GabrielBeraldo/pulvertech/pulvertech_V1/IHM/sources/boot-480x272.png

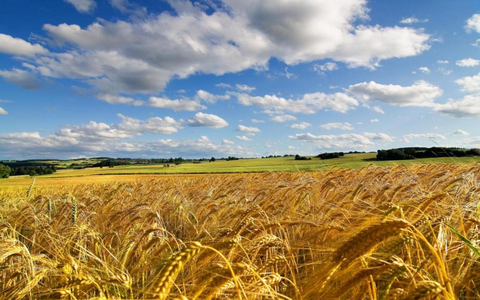
pulvertech_V1/IHM/sources/boot-480x272.png
