GabrielBeraldo/pulvertech/Logs/ControlResponse.jpg

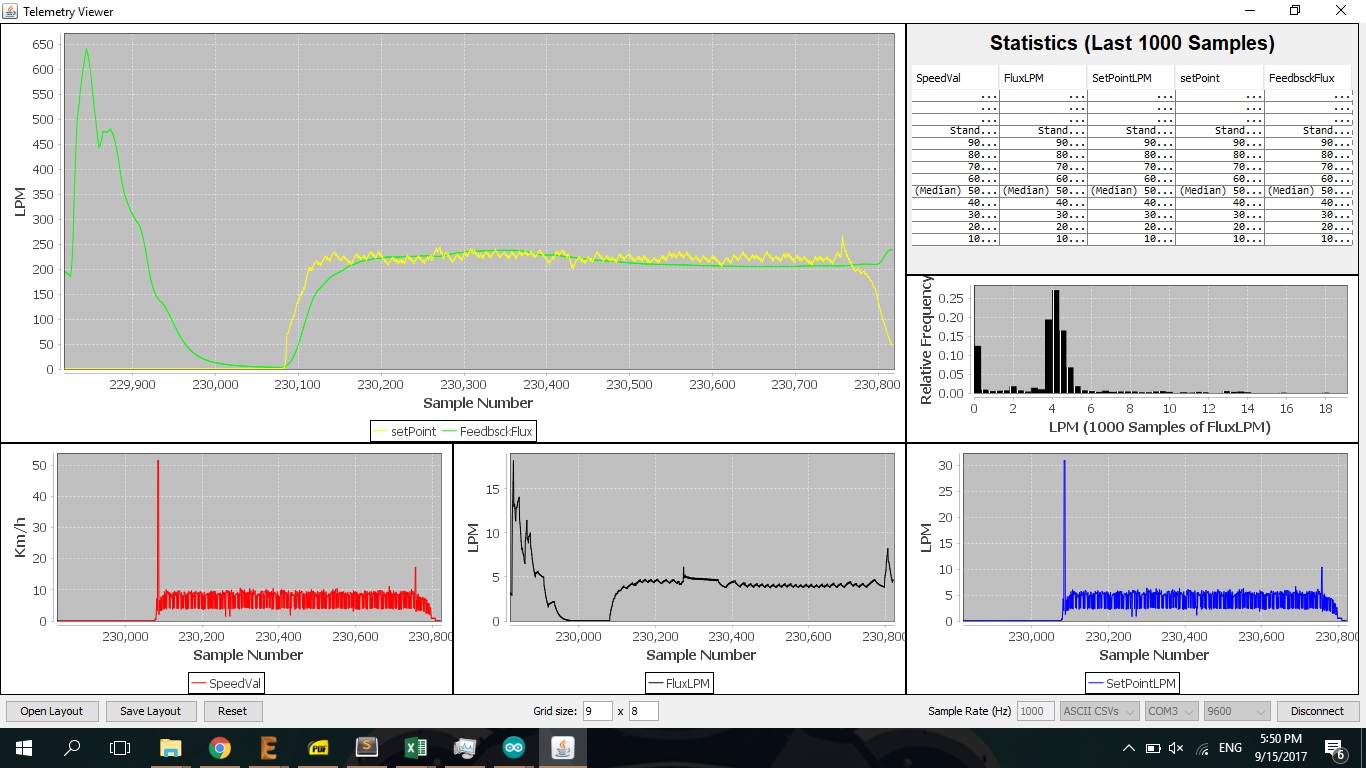
Logs/ControlResponse.jpg
