GabrielBeraldo/pulvertech/pulvertech_V1/IHM/gauges/back.jpg

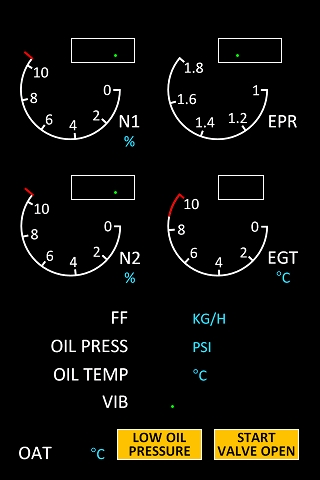
pulvertech_V1/IHM/gauges/back.jpg
