GabrielBeraldo/pulvertech/extras/fometerHoseAdapter.stl

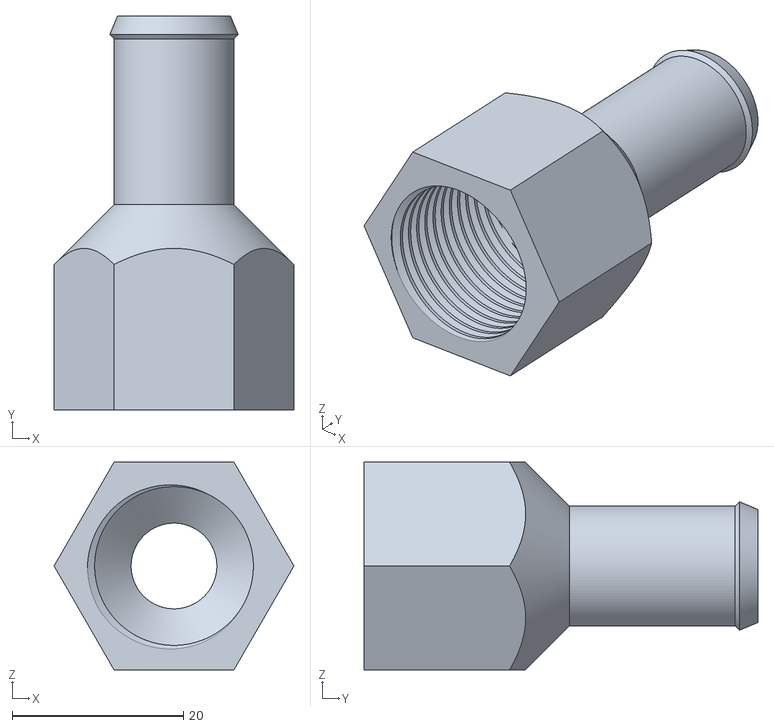
[picture p4: CAD file, 2020-08-11]
extras/fometerHoseAdapter.stl
28.0 x 46.0 x 24.2
