GabrielBeraldo/pulvertech/extras/top_case.stl

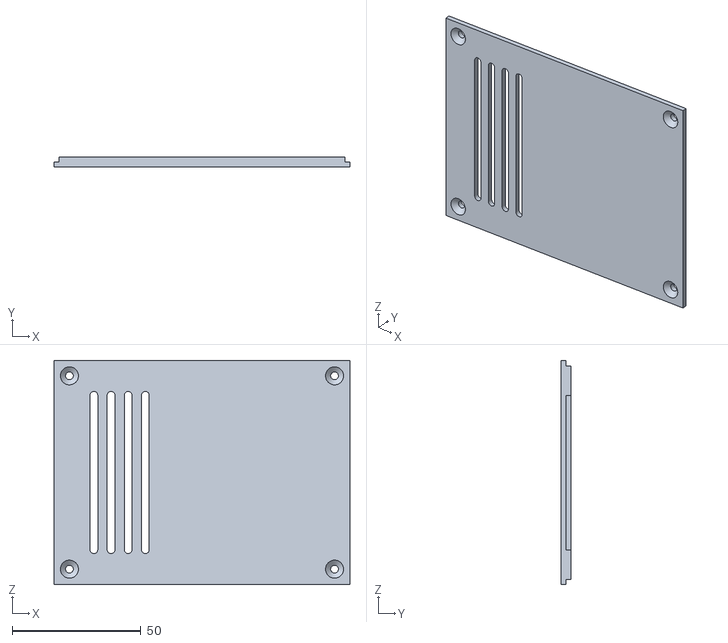
[picture p5: CAD file, 2019-11-14]
extras/top_case.stl
115.0 x 4.00 x 87.1
