GabrielBeraldo/pulvertech/extras/displayCaseBottom.stl

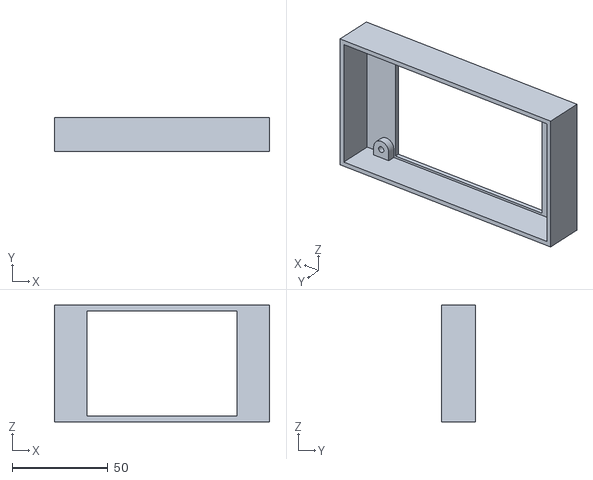
[picture p6: CAD file, 2019-11-14]
extras/displayCaseBottom.stl
112.2 x 18.0 x 61.0
