GabrielBeraldo/pulvertech/extras/displayCaseTop.stl

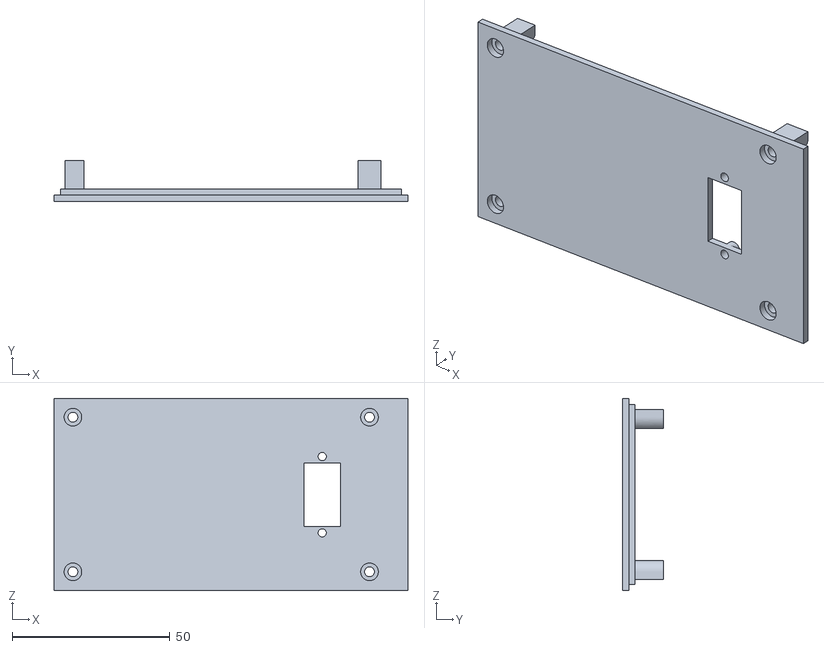
[picture p7: CAD file, 2019-11-14]
extras/displayCaseTop.stl
112.2 x 13.0 x 61.0
