GabrielBeraldo/pulvertech/extras/conector_vazao_flux.stl

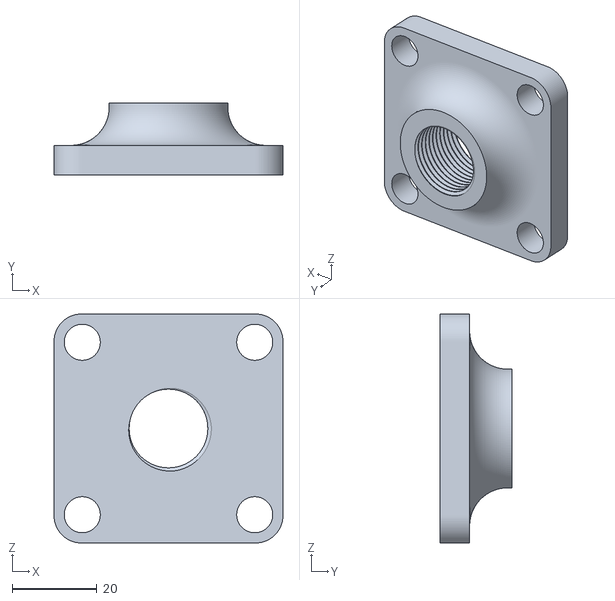
[picture p8: CAD file, 2019-06-24]
extras/conector_vazao_flux.stl
54.0 x 17.0 x 54.0
