GabrielBeraldo/pulvertech/extras/feedbackFlux15lines.stl

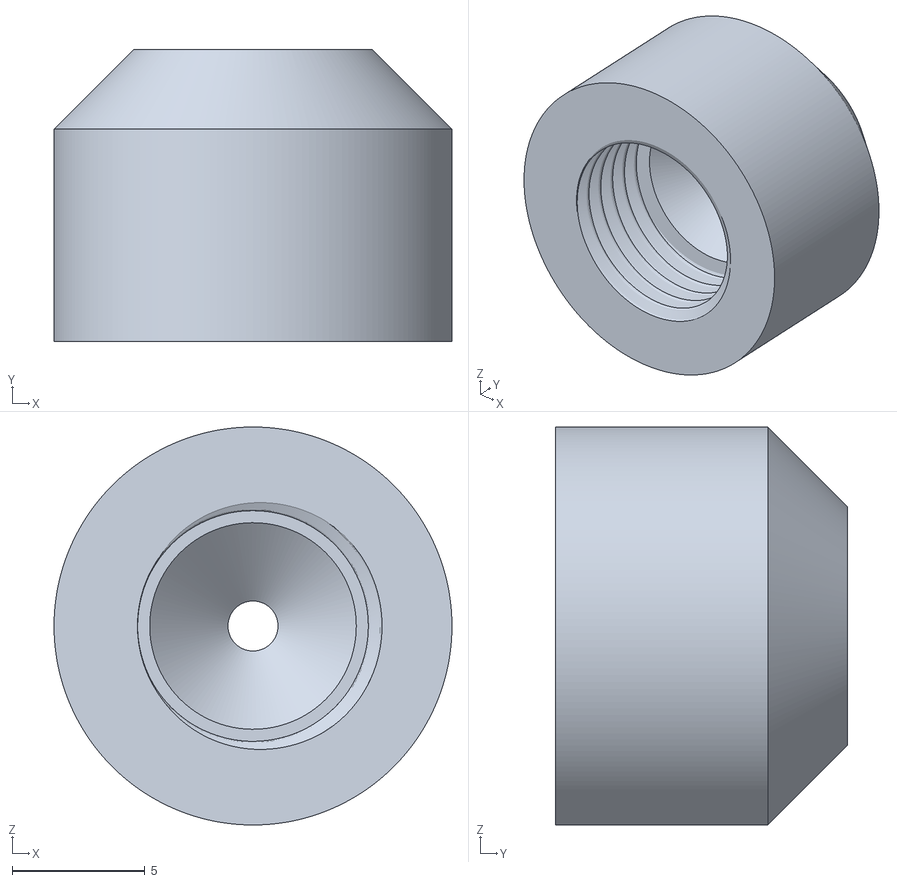
[picture p9: CAD file, 2019-06-24]
extras/feedbackFlux15lines.stl
15.0 x 11.0 x 15.0
