GabrielBeraldo/pulvertech/extras/conector_vazao.SLDPRT

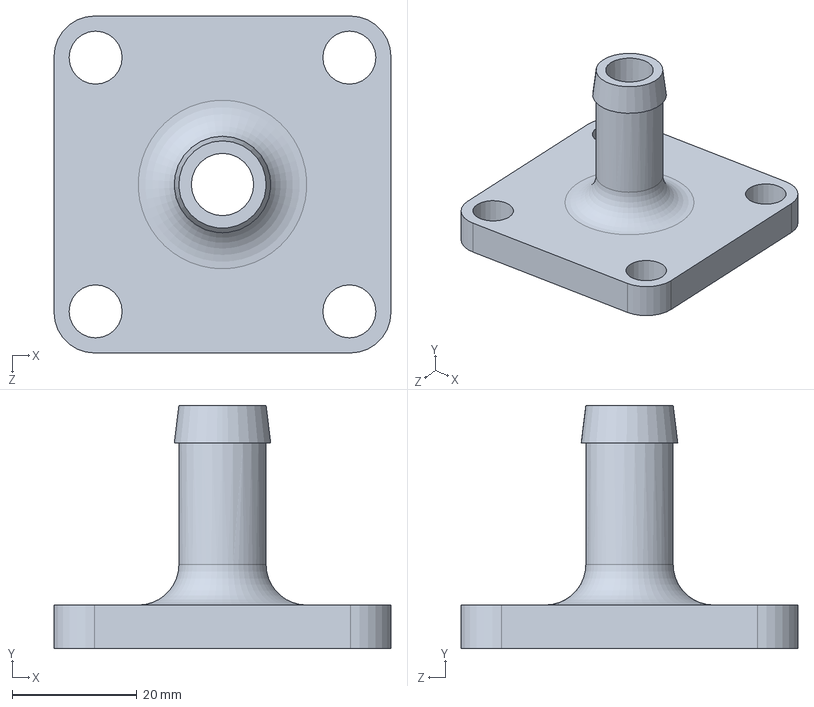
[picture p10: CAD file, 2018-02-22]
extras/conector_vazao.SLDPRT
54.0 x 39.0 x 54.0 mm
