GabrielBeraldo/pulvertech/extras/tampa_vazao.SLDPRT

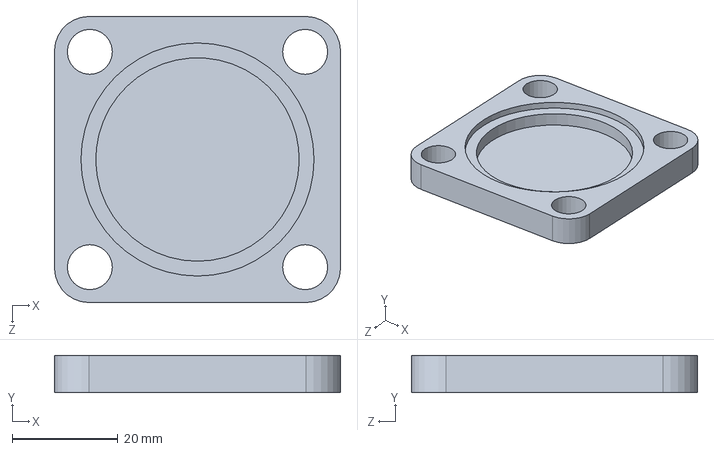
[picture p11: CAD file, 2018-02-22]
extras/tampa_vazao.SLDPRT
54.0 x 7.00 x 54.0 mm
