GabrielBeraldo/pulvertech/(list of files, cad)

Other CAD files:
extras/conector_vazao.STL
extras/tampa_vazao.STL
