GabrielBeraldo/pulvertech/Boards/PulverTech_v1/PulverTech_v1.brd

## EAGLE design Boards/PulverTech_v1/PulverTech_v1.brd (2019-11-14)

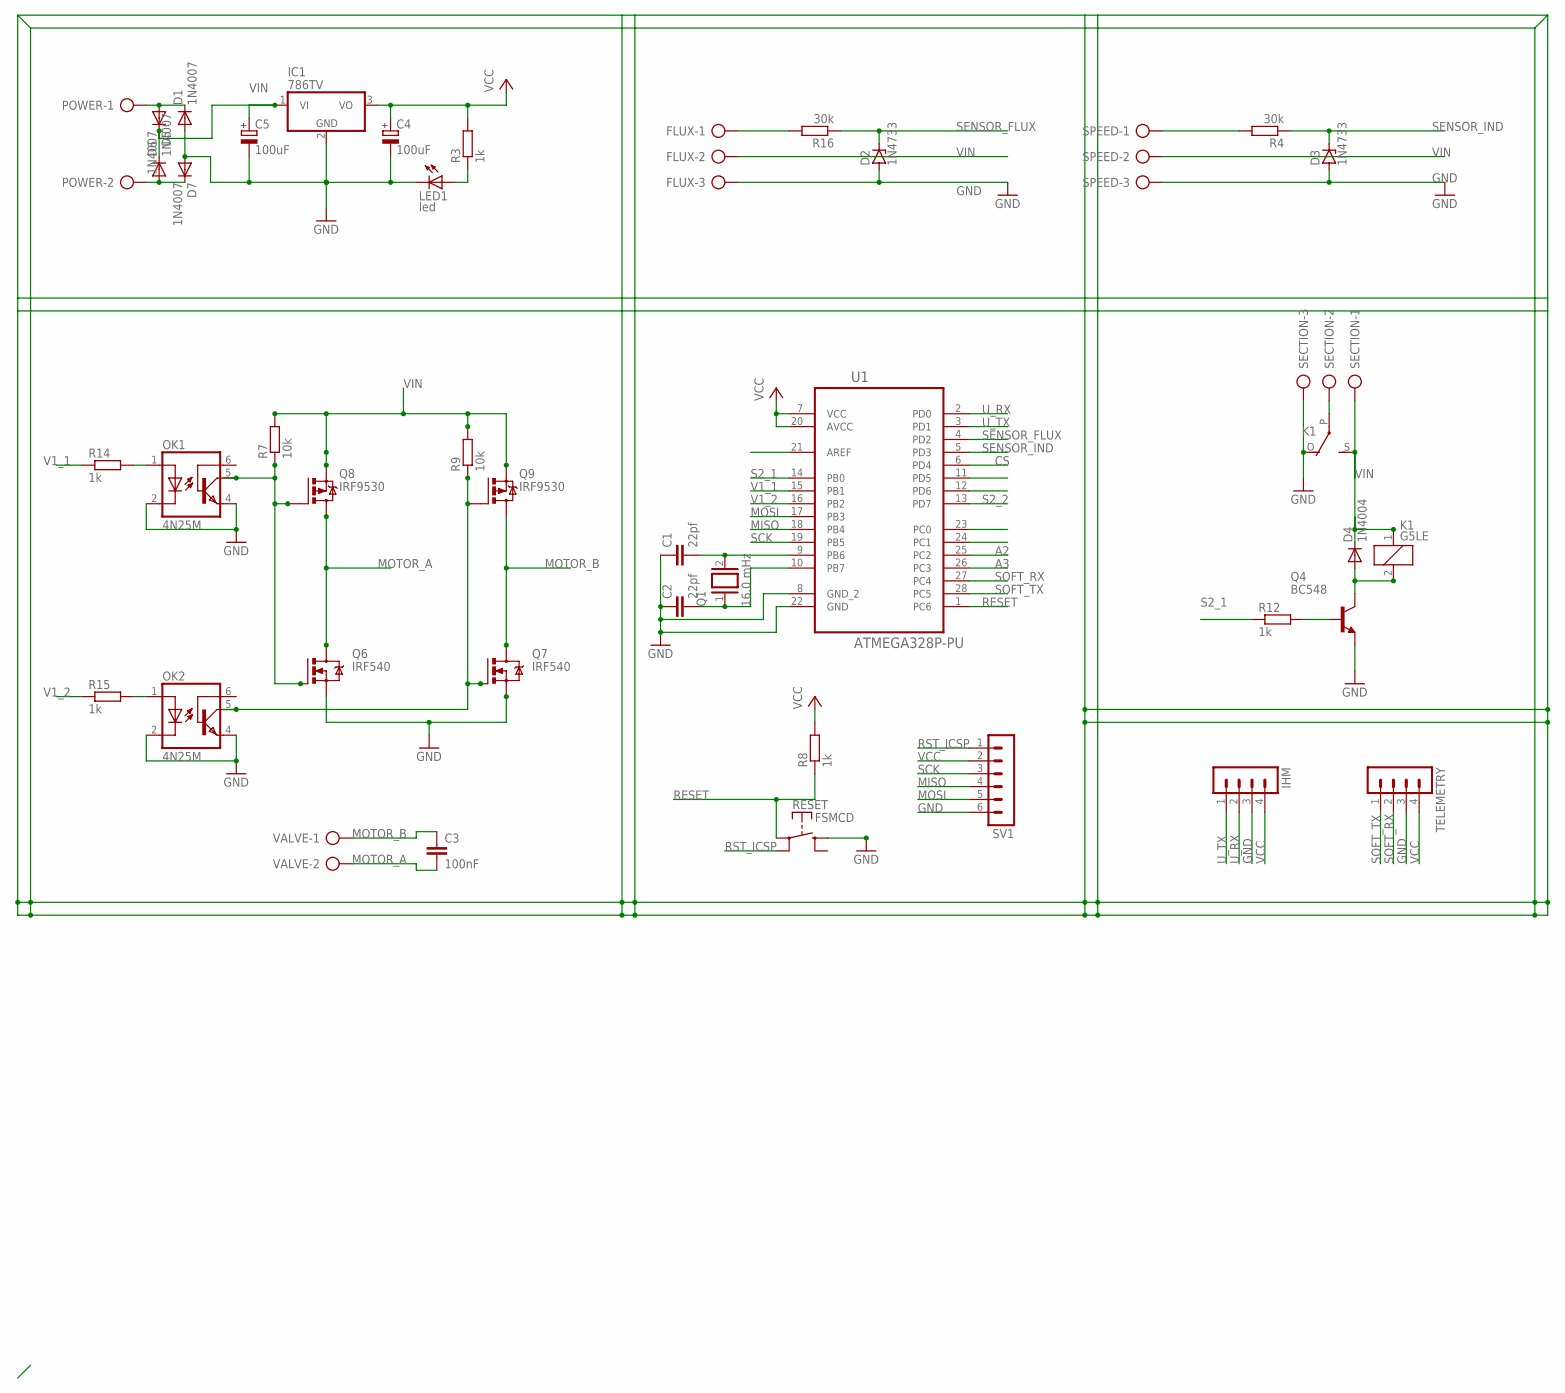
[picture p12: schematic PulverTech_v1.sch]

Parts:
C1, C2: 22pf; C025-025X050
C3: 100nF; C2.5-2
C4, C5: 100uF; E2,5-5
D1, D5, D6, D7: 1N4007; DO41-10
D2, D3: 1N4733; DO41Z10
D4: 1N4004; DO41-10
FLUX: AK500/3
IC1: 786TV; TO220V
IHM: MA04-1
K1: G5LE
LED1: led; LED3MM
OK1, OK2: 4N25M; DIL06
POWER: AK500/2
Q1: 16.0 mHz; QS
Q4: BC548; TO92-EBC
Q6, Q7: IRF540; TO220BV
Q8, Q9: IRF9530; TO220BV
R3, R8, R12, R14, R15: 1k; 0204/7
R4, R16: 30k; 0204/7
R7, R9: 10k; 0204/7
RESET: FSMCD
SECTION: AK500/3
SPEED: AK500/3
SV1: MA06-1
TELEMETRY: MA04-1
U1: ATMEGA328P-PU; DIP254P762X457-28
VALVE: AK500/2

Connections:
A2: U1.25 (PC2)
A3: U1.26 (PC3)
CS: U1.6 (PD4)
GND: C1.1, C2.1, C4.-, C5.-, D1.A, D2.A, D3.A, D7.A, FLUX.3, IC1.2 (GND), IHM.3, K1.O, LED1.K (C), OK1.2 (C), OK1.4 (EMI), OK2.2 (C), OK2.4 (EMI), Q4.E, Q6.S, Q7.S, RESET.P$3 (S), SECTION.3, SPEED.3, SV1.6, TELEMETRY.3, U1.8 (GND_2), U1.22 (GND)
GND2: K1.P, SECTION.2
MISO: SV1.4, U1.18 (PB4)
MOSI: SV1.5, U1.17 (PB3)
MOTOR_A: C3.2, Q6.D, Q8.D, VALVE.2
MOTOR_B: C3.1, Q7.D, Q9.D, VALVE.1
unnamed: C1.2, Q1.2, U1.9 (PB6)
unnamed: C2.2, Q1.1, U1.10 (PB7)
unnamed: D1.C, D5.A, POWER.1
unnamed: D6.A, D7.C, POWER.2
unnamed: R4.2, SPEED.1
unnamed: LED1.A, R3.1
unnamed: FLUX.1, R16.2
unnamed: OK1.5 (COL), Q6.G, Q8.G, R7.1
unnamed: OK1.1 (A), R14.2
unnamed: OK2.1 (A), R15.2
unnamed: D4.A, K1.2, Q4.C
unnamed: Q4.B, R12.2
unnamed: OK2.5 (COL), Q7.G, Q9.G, R9.1
RESET: R8.1, RESET.P$1, U1.1 (PC6)
RST_ICSP: RESET.P$2, SV1.1
S2_1: R12.1, U1.14 (PB0)
S2_2: U1.13 (PD7)
SCK: SV1.3, U1.19 (PB5)
SENSOR_FLUX: D2.C, R16.1, U1.4 (PD2)
SENSOR_IND: D3.C, R4.1, U1.5 (PD3)
SOFT_RX: TELEMETRY.2, U1.27 (PC4)
SOFT_TX: TELEMETRY.1, U1.28 (PC5)
U_RX: IHM.2, U1.2 (PD0)
U_TX: IHM.1, U1.3 (PD1)
V1_1: R14.1, U1.15 (PB1)
V1_2: R15.1, U1.16 (PB2)
VCC: C4.+, IC1.3 (VO), IHM.4, R3.2, R8.2, SV1.2, TELEMETRY.4, U1.7 (VCC), U1.20 (AVCC)
VIN: C5.+, D4.C, D5.C, D6.C, FLUX.2, IC1.1 (VI), K1.1, K1.S, Q8.S, Q9.S, R7.2, R9.2, SECTION.1, SPEED.2

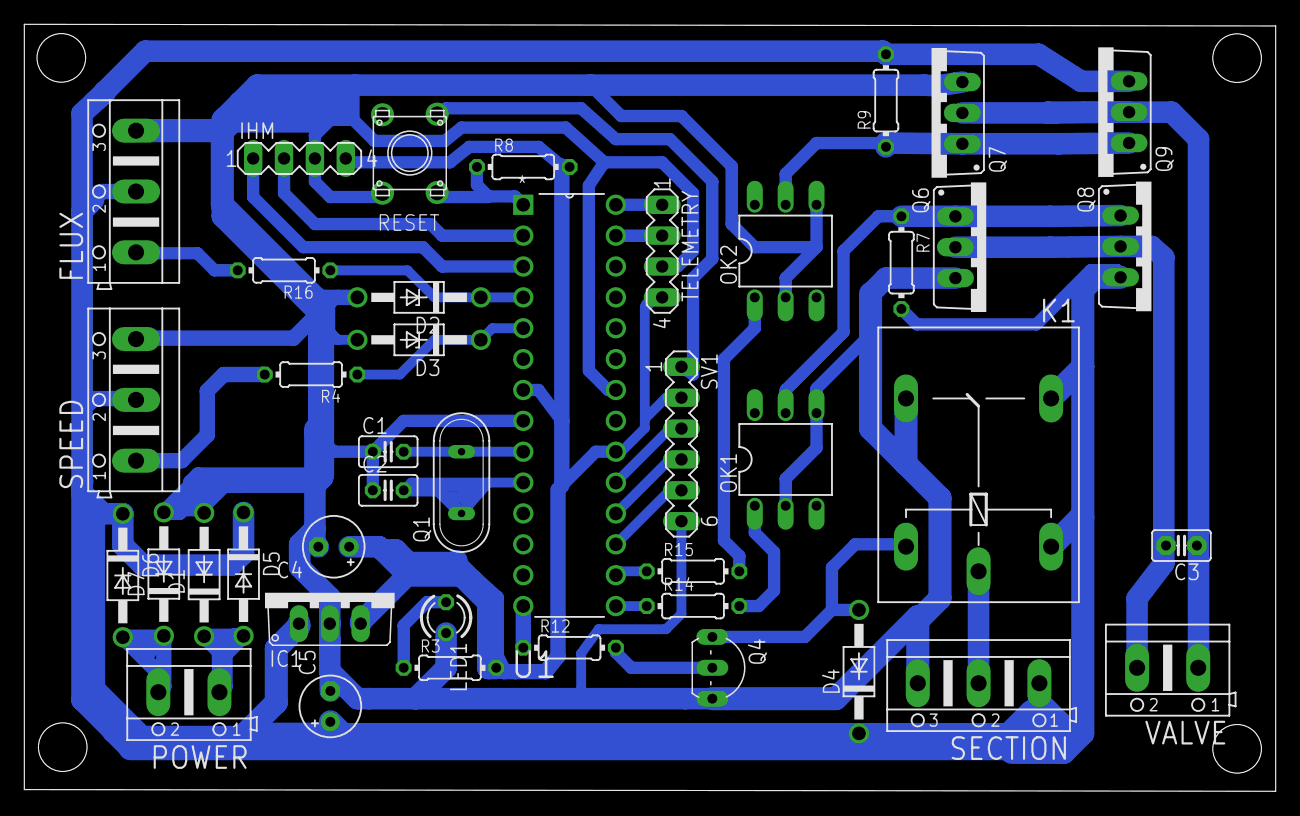
[picture p13: board PulverTech_v1.brd from above]

Board: 2 copper layers, 103.0 x 63.1 mm, 42 parts (0 on the bottom side), 33 nets.
