GabrielBeraldo/pulvertech/Boards/Pulvertech_basic/Pulvertech_basic.brd

## EAGLE design Boards/Pulvertech_basic/Pulvertech_basic.brd (2018-07-21)

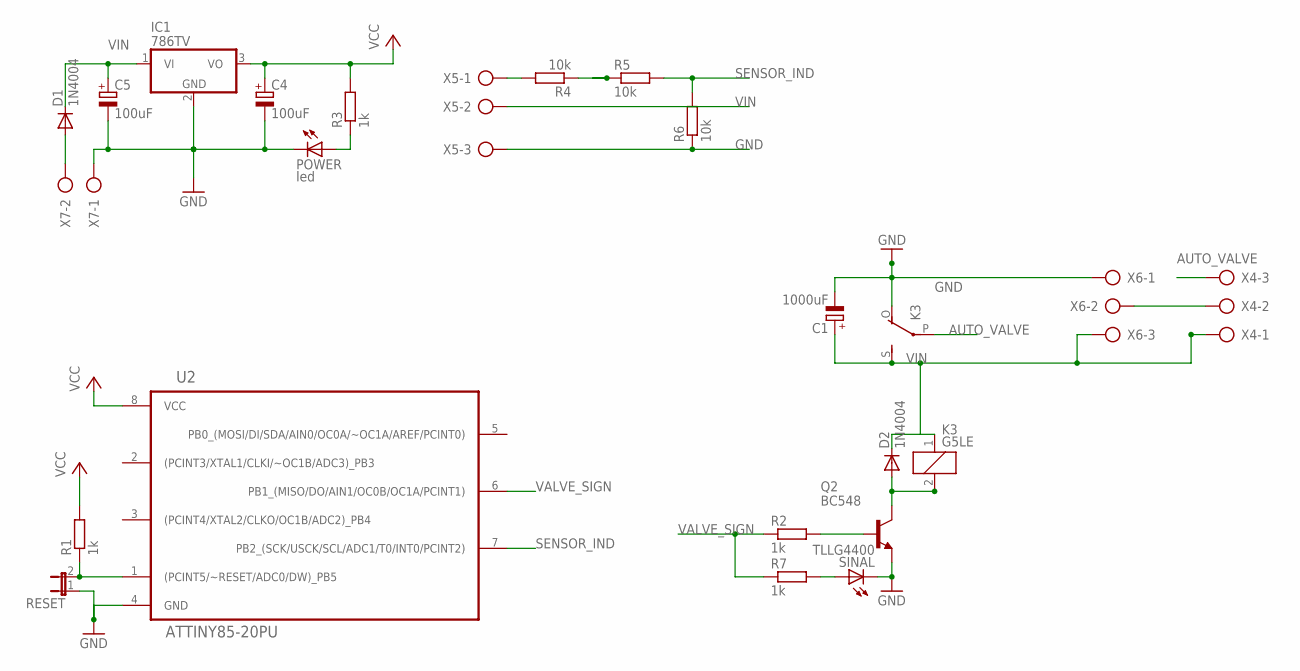
[picture p14: schematic Pulvertech_basic.sch]

Parts:
C1: 1000uF; E5-10,5
C4, C5: 100uF; E2,5-5
D1, D2: 1N4004; DO41-10
IC1: 786TV; TO220V
K3: G5LE
POWER: led; LED3MM
Q2: BC548; TO92-EBC
R1, R2, R3, R7: 1k; 0204/7
R4, R5, R6: 10k; 0204/7
RESET: JP1E; JP1
SINAL: TLLG4400; LED3MM
U2: ATTINY85-20PU; DIP254P762X533-8
X4, X5, X6: AK500/3
X7: AK500/2

Connections:
AUTO_VALVE: K3.P, X4.3
GND: C1.-, C4.-, C5.-, IC1.2 (GND), K3.O, POWER.K (C), Q2.E, R6.1, RESET.1, SINAL.K (C), U2.4 (GND), X5.3, X6.1, X7.1
unnamed: R1.1, RESET.2, U2.1 ((PCINT5/~RESET/ADC0/DW)_PB5)
unnamed: R4.2, X5.1
unnamed: Q2.B, R2.2
unnamed: X4.2, X6.2
unnamed: D1.A, X7.2
unnamed: R7.2, SINAL.A
unnamed: POWER.A, R3.1
unnamed: D2.A, K3.2, Q2.C
unnamed: R4.1, R5.1
SENSOR_IND: R5.2, R6.2, U2.7 (PB2_(SCK/USCK/SCL/ADC1/T0/INT0/PCINT2))
VALVE_SIGN: R2.1, R7.1, U2.6 (PB1_(MISO/DO/AIN1/OC0B/OC1A/PCINT1))
VCC: C4.+, IC1.3 (VO), R1.2, R3.2, U2.8 (VCC)
VIN: C1.+, C5.+, D1.C, D2.C, IC1.1 (VI), K3.1, K3.S, X4.1, X5.2, X6.3

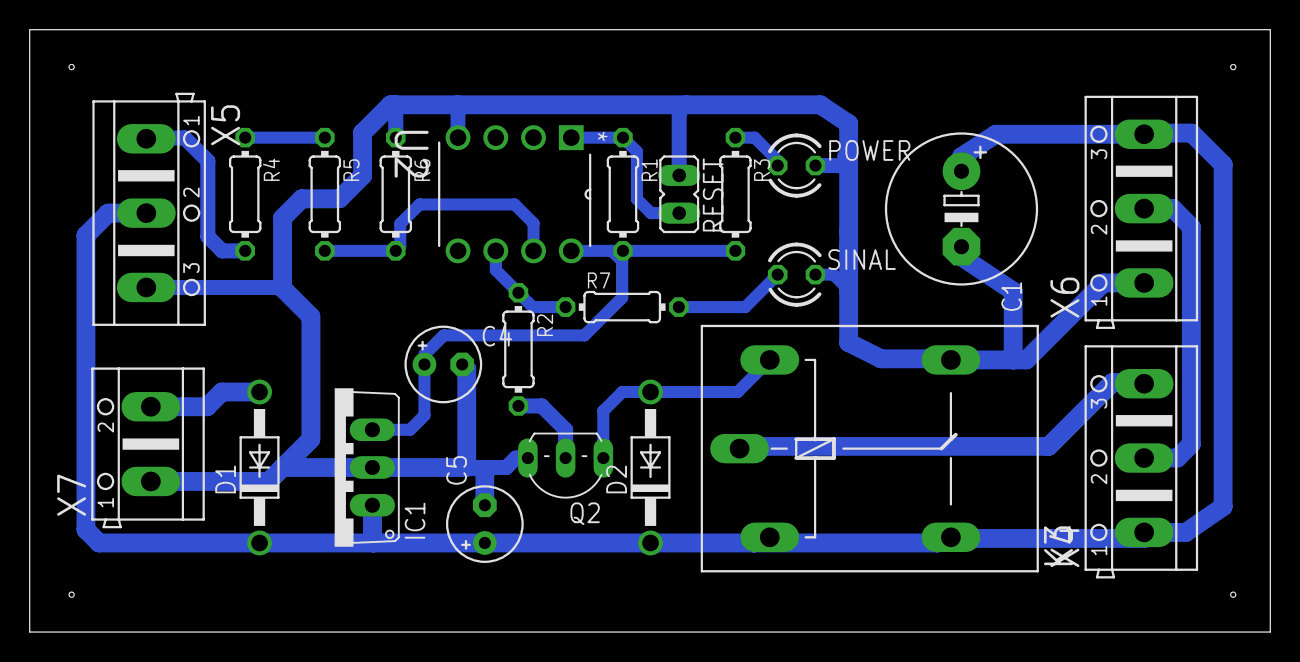
[picture p15: board Pulvertech_basic.brd from above]

Board: 2 copper layers, 83.5 x 40.5 mm, 23 parts (0 on the bottom side), 15 nets.
