GabrielBeraldo/pulvertech/pulvertech_V1/Pulvertech_V1_raw/src/Configurations.h

#define telemetry
#define SILENT_TELEMETRY false

#define displayBaudrate 9600
#define BaudRate 9600

#define sampleTime 100

#define displayDelay 10

#define MinSpeed 2.0
#define DelayValve 3000 //3 seconds for open/close the section valve
#define ButtonPressTime 1000
#define SpeedSimulationVal 5

#define MeterCalibrationAdd 1
#define PulsesPerLiterAdd   25
#define MachineWidthAdd     50
#define LiterPerHaAdd       75
#define ProportionalAdd     100
#define IntegrativeAdd      125
#define DerivativeAdd       150

#define CalibStateAdd 0

#define _EMEA 10
#define _EEST 10
#define _Q 2

#define s_EMEA 10
#define s_EEST 10
#define s_Q 0.5

#define loweracquisitionSetpoint 250
#define upperacquisitionSetpoint 500
