GabrielBeraldo/pulvertech/pulvertech_V1/Pulvertech_V1_raw/src/EEPROM_ANY.h

#include <EEPROM.h>
//#include <Arduino.h>  // for type definitions


template <class T> int eepromWrite(int ee, const T &value)
{
    const byte *p = (const byte *)(const void *)&value;
    unsigned int i;
    for (i = 0; i < sizeof(value); i++)
        EEPROM.write(ee++, *p++);
    return i;
}

template <class T> int eepromRead(int ee, T &value)
{
    byte *p = (byte *)(void *)&value;
    unsigned int i;
    for (i = 0; i < sizeof(value); i++)
        *p++ = EEPROM.read(ee++);
    return i;
}
