GabrielBeraldo/pulvertech/(commit log)

2018-02-22 summ
    first commit
    [PID.xls, conector_vazao.SLDPRT, conector_vazao.STL, tampa_vazao.SLDPRT, tampa_vazao.STL]
2018-03-01 New board integrated
    removed sd card support
    add filters on speed next values
2018-03-01 Boards add
    some organization
    [PID.xls, PulverTech_v1.brd, PulverTech_v1.dxf, PulverTech_v1.sch, Pulvertech_basic.brd, Pulvertech_basic.dxf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]
2018-03-03 update
    corrections and updates
    [Flux.h, Pulvertech_V1.ino, Speed.h]
2018-03-29 add aquisition features
    [acquisition01_p120.csv, acquisition02_p120.csv, acquisition03_p120.csv, acquisition04_p100.csv, acquisition05_p100.csv, acquisitionMatlab.csv, aquisition p2_i0_d0.xlsx, forMatlabAcquisition04_p100.csv]
2018-07-19 update for manufactoring
    [BOM.xlsx, Pulvertech_basic.brd, Pulvertech_basic.csv, acquisition06_p100.csv, acquisition06_p100_secondStage.csv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]
2018-07-21 updates for manufactoring
    [Pulvertech_basic.brd, Pulvertech_basic.dxf]
2018-07-30 Add optocouplers, changed sensor input for flux and minor changes
    [PulverTech_v1.brd, PulverTech_v1.sch]
2019-06-24 *updates upload
    [Configurations.h, PID.xls, acquisitionPlant1.csv, acquisitionReal_01.csv, acquisitionReal_02.csv, acquisitionReal_03_openLoop.csv, acquisitionReal_04_openLoop.csv, acquisitionReal_closedLoop_p1.csv]
2019-11-14 final project updates
    [BOM.csv, BOM.xlsx, Configurations.h, PulverTech_v1.brd, PulverTech_v1.dxf, PulverTech_v1.sch, PulverTech_v1_BOM.csv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]
2020-08-11 nextion implementation git update
    [fometerHoseAdapter.stl]
